uqmars/starter-micromouse/README.md

# UQ MARS Starter Micromouse Design

This repository houses the design and drivers for the starter Micromouse design provided by UQ MARS.

To find out more about the Micromouse competition, see the rules [here](https://github.com/uqmars/micromouse-spec/releases).
