uqmars/starter-micromouse/PCB V2 Design/README.md

# MARS_Micromouse
Micromouse pcb designed for the UQ MARS micromouse workshop series.
