uqmars/starter-micromouse/PCB V2 Design/Bill of Materials.xlsx

Sheet: Robot
Name | Type | Material | Qty | Cost | Subtotal | Link
Micromouse PCB Assembly | Internally Manufactured |  | 1 | -
Top Plate 3D Print | 3D Printed | PLA | 1 | -
Base Plate 3D Print | 3D Printed | PLA | 1 | -
Motor Clamp 3D Print | 3D Printed | PLA | 2 | -
Caster Ball Extension 3D Print | 3D Printed | PLA | 1 | -
IR Proximity Sensor | Purchased |  | 3 | $0.70 | $2.10 | Aliexpress (https://www.aliexpress.com/item/1005006749168692.html)
N20 Motor with Encoder (6V 100RPM) | Purchased |  | 2 | $9.33 | $18.66 | Aliexpress (https://www.aliexpress.com/item/1005007571722097.html)
N20 Motor 43mm Wheel | Purchased |  | 2 | $1.60 | $3.20 | Aliexpress (https://www.aliexpress.com/item/1005007811650639.html)
Caster Ball | Purchased |  | 1 | $0.50 | $0.50 | Aliexpress (https://www.aliexpress.com/item/1005008096943126.html)
M3 x 8mm Hex Button Screw | Purchased | Stainless Steel | 15 | $0.10 | $1.50 | Aliexpress (https://www.aliexpress.com/item/32967225441.html?curPageLogUid=vMDo78oz88UZ)
3.7V 1S 2000mAh LiPo Battery | Purchased |  | 1 | $15.30 | $15.30 | Core Electronics (https://core-electronics.com.au/polymer-lithium-ion-battery-2000mah-38459.html)
USB-C Lipo Charger | Purchased |  | 1 | $7.60 | $7.60 | Core Electronics (https://core-electronics.com.au/makerverse-usb-c-lipo-charger.html)
Raspberry Pi Pico | Purchased |  | 1 | $3.89 | $3.89 | Aliexpress (https://www.aliexpress.com/item/1005007393927221.html)
JST XH 6-Pin Male/Female Pair (straight) | Purchased |  | 2 | $0.33 | $0.66 | Aliexpress (https://www.aliexpress.com/item/1005007080333485.html)
JST PH 2-Pin Male PCB Connector (straight) | Purchased |  | 1 | $0.02 | $0.02 | Aliexpress (https://www.aliexpress.com/item/1005004708000514.html)
 |  |  | Total: |  | $52.75

Sheet: PCB
Index | DigiKey Part # | Manufacturer Part Number | Manufacturer | Description | Customer Reference | Quantity | Backorder | Unit Price | Extended Price
1 | 2223-SLW-1678105-6A-N-D-ND | SLW-1678105-6A-N-D | Same Sky (Formerly CUI Devices) | 16 X 7.8 X 10.5 MM, 6 MM RAISED |  | 18 | 0 | $0.98 | $17.62
2 | 5399-SL2301SCT-ND | SL2301S | Shenzhen Slkormicro Semicon Co., Ltd. | 20V 2.4A 140M@4.5V,2.4A 900MW 1. |  | 35 | 0 | $0.10 | $3.43
3 | 5399-DSK24CT-ND | DSK24 | Shenzhen Slkormicro Semicon Co., Ltd. | 40V 550MV@2A 2A SOD-123FL |  | 35 | 0 | $0.11 | $3.71
4 | 296-DRV8210DRLRCT-ND | DRV8210DRLR | Texas Instruments | 12-V, 1.76-A BRUSHED DC MOTOR DR |  | 35 | 0 | $0.70 | $24.42
5 | 311-10KJRCT-ND | RC0402JR-0710KL | YAGEO | RES 10K OHM 5% 1/16W 0402 |  | 500 | 0 | $0.00448 | $2.24
6 | 311-100KLRCT-ND | RC0402FR-07100KL | YAGEO | RES 100K OHM 1% 1/16W 0402 |  | 250 | 0 | $0.0049 | $1.23
7 | 13-RC0402JR-13220RLCT-ND | RC0402JR-13220RL | YAGEO | RES 220 OHM 5% 1/16W 0402 |  | 100 | 0 | $0.0041 | $0.41
8 | 399-C0603C104K5RACTUCT-ND | C0603C104K5RACTU | KEMET | CAP CER 0.1UF 50V X7R 0603 |  | 100 | 0 | $0.02 | $1.70
 |  |  |  |  |  |  |  | Subtotal | $54.76
 | Please note that the table shown above is the order placed to manufacture 16 robot units. This includes spare parts due to errors during manufacturing. Refer to the table below for exact quantities required for a single PCB
Index | DigiKey Part # | Manufacturer Part Number | PCB Designator | Description | Quantity | Unit Price | Extended Price
1 | 2223-SLW-1678105-6A-N-D-ND | SLW-1678105-6A-N-D | SW2 | 16 X 7.8 X 10.5 MM, 6 MM RAISED | 1 | $0.98 | $0.98
2 | 5399-SL2301SCT-ND | SL2301S | Q1, Q2 | 20V 2.4A 140M@4.5V,2.4A 900MW 1. | 2 | $0.10 | $0.20
3 | 5399-DSK24CT-ND | DSK24 | D3 | 40V 550MV@2A 2A SOD-123FL | 1 | $0.11 | $0.11
4 | 296-DRV8210DRLRCT-ND | DRV8210DRLR | U1, U2 | 12-V, 1.76-A BRUSHED DC MOTOR DR | 2 | $0.70 | $1.40
5 | 311-10KJRCT-ND | RC0402JR-0710KL | R3, R7 | RES 10K OHM 5% 1/16W 0402 | 2 | $0.00448 | $0.01
6 | 311-100KLRCT-ND | RC0402FR-07100KL | R4 | RES 100K OHM 1% 1/16W 0402 | 1 | $0.0049 | $0.0049
7 | 13-RC0402JR-13220RLCT-ND | RC0402JR-13220RL | R1, R2 | RES 220 OHM 5% 1/16W 0402 | 2 | $0.0041 | $0.01
8 | 399-C0603C104K5RACTUCT-ND | C0603C104K5RACTU | C1, C7, C6 | CAP CER 0.1UF 50V X7R 0603 | 3 | $0.02 | $0.05
9 | 160-1179-1-ND | LTST-C170GKT | D2 | LED GREEN CLEAR SMD | 1 | $0.16 | $0.16
10 | 160-1427-1-ND | LTST-C171KRKT | D1 | LED RED CLEAR SMD | 1 | $0.21 | $0.21
 |  |  |  |  |  | Subtotal | $3.12
Generic electrolytic capacitors will need to be purchased for (C2, C3, C4, and C5)
Generic THT 6mm pushbutons should be purchased for (SW1, and SW2)
2.54mm male pin headers should be purchased for most of the breakout pins
2x20mm Female pin headers need to be purchased for mounting the Raspberry Pi on the board.
