uqmars/starter-micromouse/CAD/STL/Motor Clamp.stl

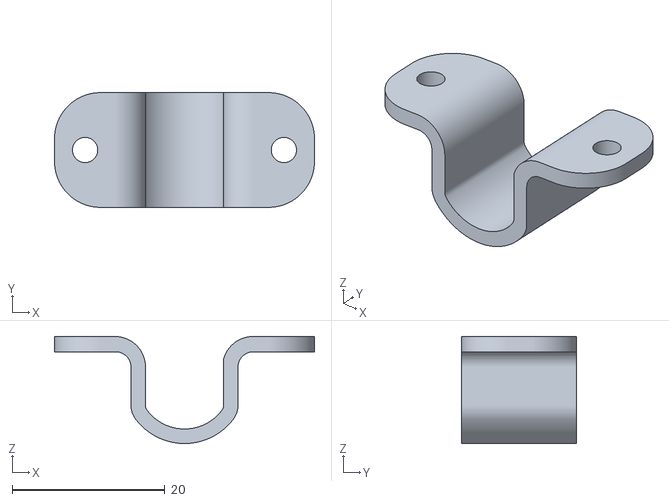
[picture p2: CAD file, 2026-08-11]
CAD/STL/Motor Clamp.stl
34.0 x 15.0 x 14.0
