uqmars/starter-micromouse/PCB V2 Design/MARS_Micromouse_PCB.step

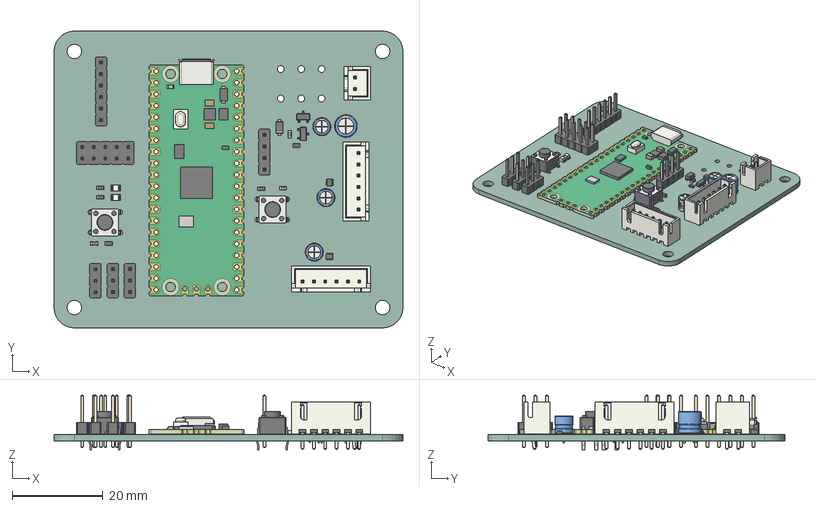
[picture p3: CAD file, 2026-01-06]
PCB V2 Design/MARS_Micromouse_PCB.step
77.0 x 65.5 x 12.0 mm
SOT-23 x 2
PinHeader_1x03_P2.54mm_Vertical x 3
SW_PUSH_6mm_H5mm x 2
JST_XH_B6B-XH-A_1x06_P2.50mm_Vertical x 2
C_0603_1608Metric x 3
R_0603_1608Metric x 5
LED_0805_2012Metric x 2
SOT-563 x 2
PinHeader_1x04_P2.54mm_Vertical
CP_Radial_D5.0mm_P2.50mm
D_SOD-123F
RaspberryPi_Pico_Module_KiCad
JST_XH_B2B-XH-A_1x02_P2.50mm_Vertical
CP_Radial_D4.0mm_P2.00mm x 3
PinHeader_2x05_P2.54mm_Vertical
PinHeader_1x06_P2.54mm_Vertical
MARS_Micromouse_PCB
