uqmars/starter-micromouse/CAD/STL/Top Plate.stl

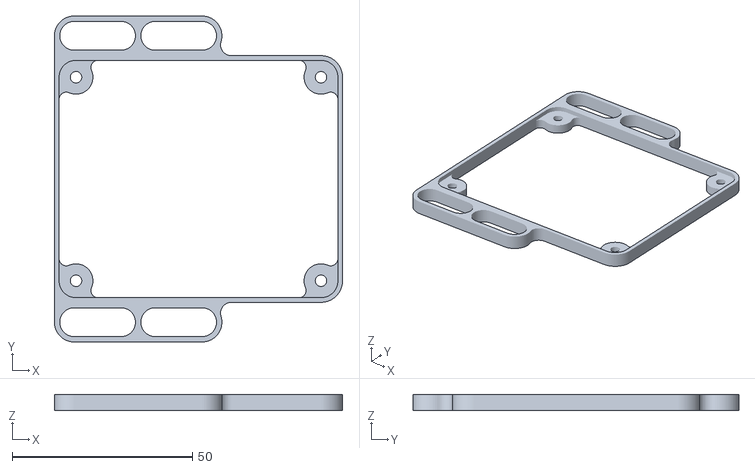
[picture p4: CAD file, 2026-08-11]
CAD/STL/Top Plate.stl
80.0 x 90.5 x 4.51
