uqmars/starter-micromouse/CAD/STL/Caster Ball Extension.stl

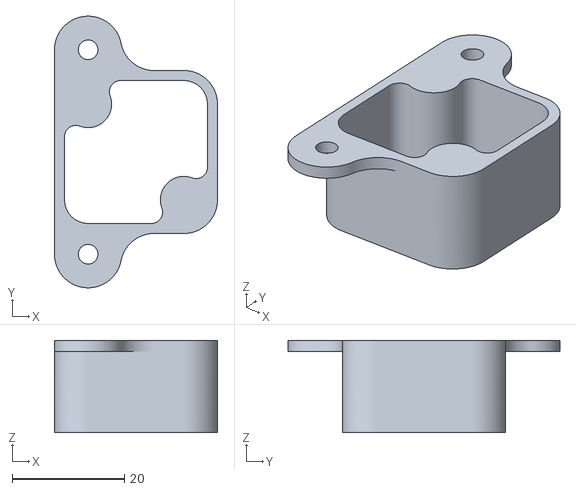
[picture p5: CAD file, 2026-08-11]
CAD/STL/Caster Ball Extension.stl
29.1 x 48.5 x 16.5
