uqmars/starter-micromouse/CAD/STL/Base Plate.stl

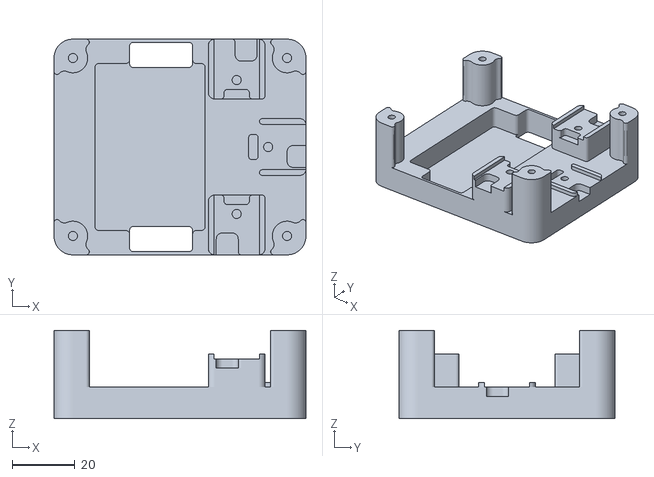
[picture p6: CAD file, 2026-08-11]
CAD/STL/Base Plate.stl
80.0 x 68.5 x 28.0
