uqmars/starter-micromouse/(list of files, cad)

Other CAD files:
CAD/MARS Micromouse.f3z
CAD/MARS Micromouse.ipn
CAD/MARS Micromouse/Base Plate.ipt
CAD/MARS Micromouse/CP_Radial_D4.0mm_P2.00mm.ipt
CAD/MARS Micromouse/CP_Radial_D5.0mm_P2.50mm.ipt
CAD/MARS Micromouse/C_0603_1608Metric.ipt
CAD/MARS Micromouse/Caster Ball Extension.ipt
CAD/MARS Micromouse/Caster Ball v3.ipt
CAD/MARS Micromouse/D_SOD-123F.ipt
CAD/MARS Micromouse/Housing.ipt
CAD/MARS Micromouse/Hub.ipt
CAD/MARS Micromouse/IR_Sensor_YL63 v1.ipt
CAD/MARS Micromouse/JST_XH_B2B-XH-A_1x02_P2.50mm_Vertical.ipt
CAD/MARS Micromouse/JST_XH_B6B-XH-A_1x06_P2.50mm_Vertical.ipt
CAD/MARS Micromouse/LED_0805_2012Metric.ipt
CAD/MARS Micromouse/MARS Micromouse.iam
CAD/MARS Micromouse/MARS_Micromouse_PCB v1.iam
CAD/MARS Micromouse/MARS_Micromouse_PCB.ipt
CAD/MARS Micromouse/Motor Clamp.ipt
CAD/MARS Micromouse/N20 Mini Micro Metall Gear Motor v1.ipt
CAD/MARS Micromouse/New Battery.ipt
CAD/MARS Micromouse/OldVersions/RC wheel v1.0002.iam
CAD/MARS Micromouse/PinHeader_1x03_P2.54mm_Vertical.ipt
CAD/MARS Micromouse/PinHeader_1x04_P2.54mm_Vertical.ipt
CAD/MARS Micromouse/PinHeader_1x06_P2.54mm_Vertical.ipt
CAD/MARS Micromouse/PinHeader_2x05_P2.54mm_Vertical.ipt
CAD/MARS Micromouse/RC wheel v1.iam
CAD/MARS Micromouse/R_0603_1608Metric.ipt
CAD/MARS Micromouse/RaspberryPi_Pico.iam
CAD/MARS Micromouse/RaspberryPi_Pico_Module_KiCad.ipt
CAD/MARS Micromouse/SOT-23.ipt
CAD/MARS Micromouse/SOT-563.ipt
CAD/MARS Micromouse/SW_PUSH_6mm_H5mm.ipt
CAD/MARS Micromouse/Top Plate.ipt
CAD/OldVersions/MARS Micromouse.0001.ipn
