uqmars/starter-micromouse/CAD/Micromouse Starter Robot Assembly Instructions.docx

Micromouse Starter Robot Assembly Instructions

Author | Binara Wasala
Last Revision | 12/07/2026
Revision | A

Parts:

Part | Qty.
3.7V LiPo Battery | 1
43mm Rubber Wheel | 2
Caster Ball | 1
IR Sensor | 3
M3x8mm Hex Socket Bolt | 15
Micro Motor 60RPM | 2
MM Base Plate | 1
MM Caster Ball Extension | 1
MM Motor Clamp | 2
MM PCB | 1
MM Top Plate | 1

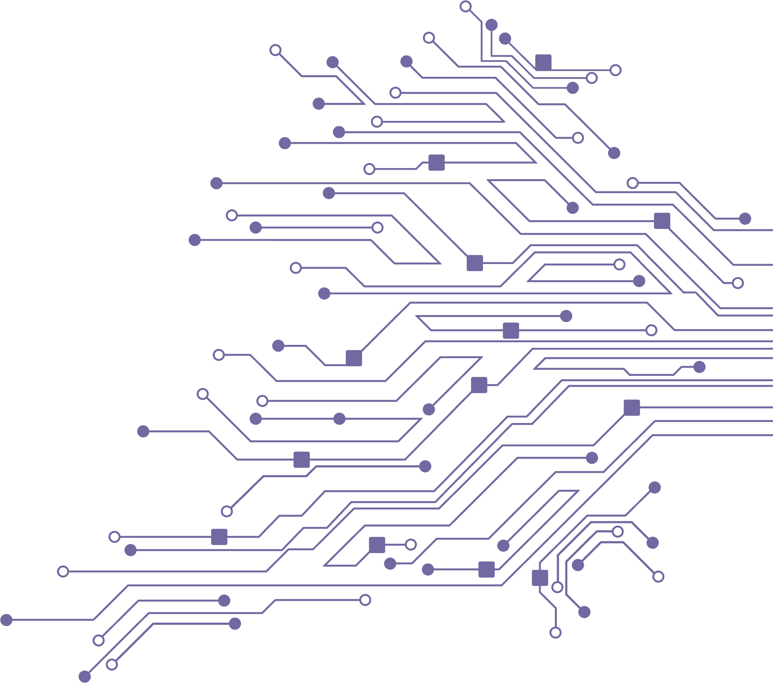
[picture p7: figure]

| Micromouse Starter Robot | Step: | 1

Parts Required:

A. 1 x MM Base Plate
B. 1 x MM Caster Ball Extension
C. 2 x M3x8mm Hex Socket Bolt

Instructions:

1. Fasten the MM Caster Ball Extension (B) to the MM Base Plate (A) using M3x8mm bolts (C).

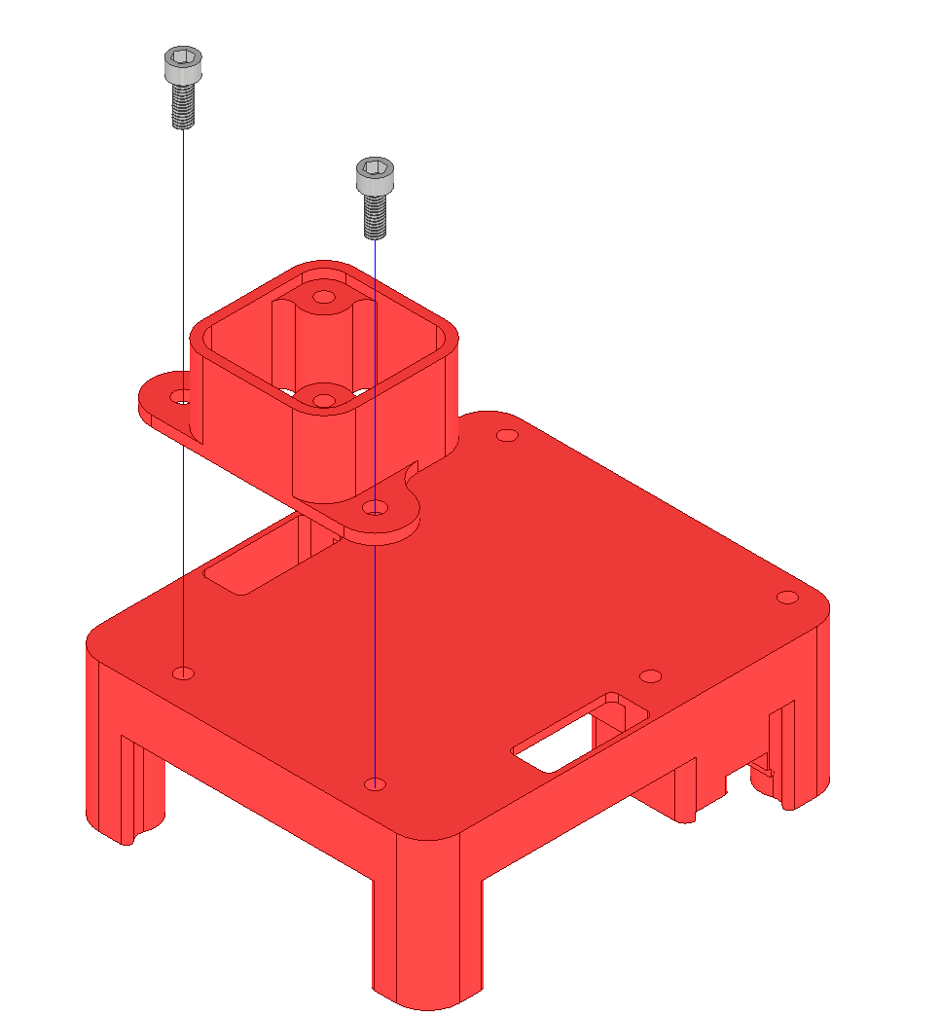
[picture p8: figure]

2 x C

B

A
| Micromouse Starter Robot | Step: | 2

Parts Required:

A. 1 x MM Base Plate with components fitted (where step 1 of this procedure has been completed)
B. 1 x Caster Ball
C. 2 x M3x8mm Hex Socket Bolt

Instructions:

1. Fasten the Caster Ball (B) to the MM Base Plate (A) using M3x8mm bolts (C).

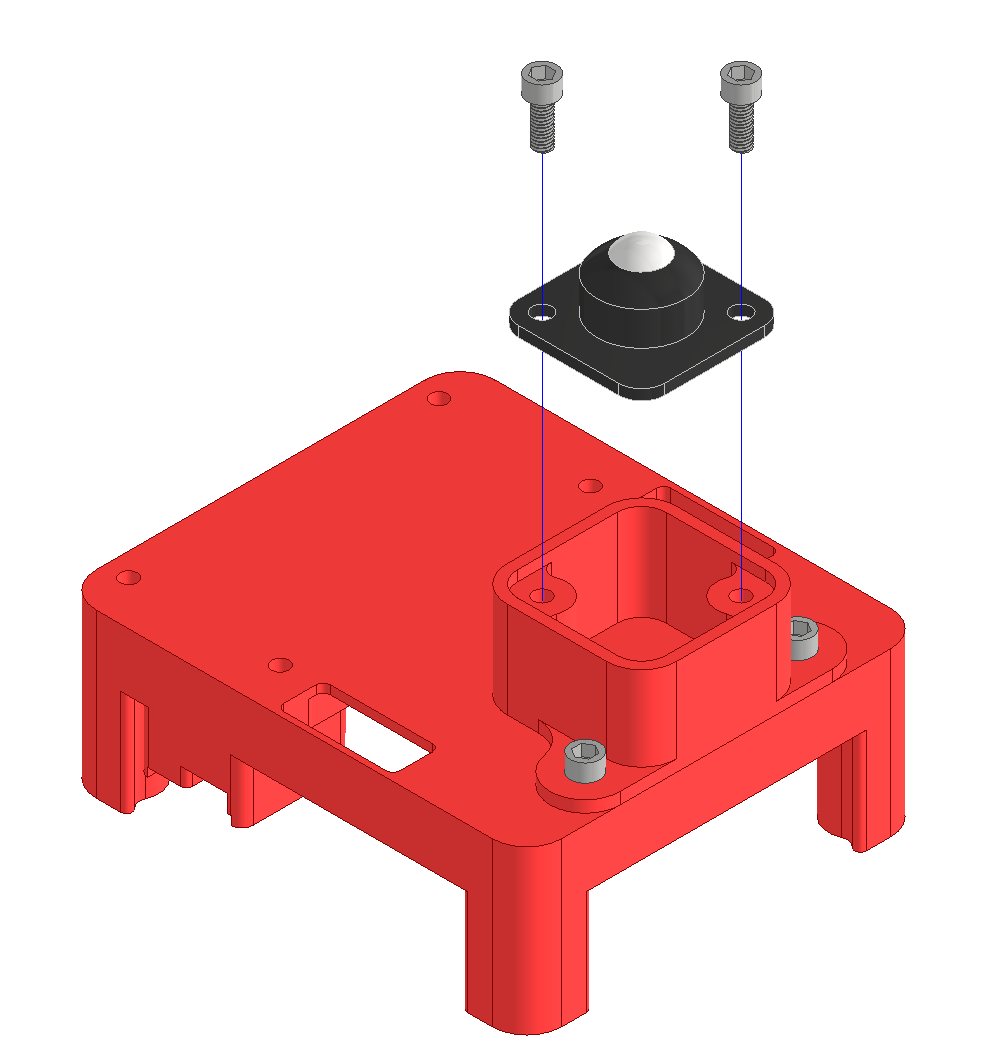
[picture p9: figure]

2 x C

A

B
| Micromouse Starter Robot | Step: | 3

Parts Required:

A. 1 x MM Base Plate with components fitted (where steps 1 to 2 of this procedure have been completed)
B. 2 x MM Motor Clamp
C. 2 x Micro Motor 60RPM
D. 4 x M3x8mm Hex Socket Bolt

Instructions:

1. Place the Micro Motors (C) on the MM Base Plate (A) and secure using MM Motor Clamps (B).
2. Fasten the MM Motor Clamps (B) to the MM Base Plate (A) using M3x8mm bolts (D).
3. Route the cables from the Micro Motors (C) through the designated holes in the MM Base Plate (A).

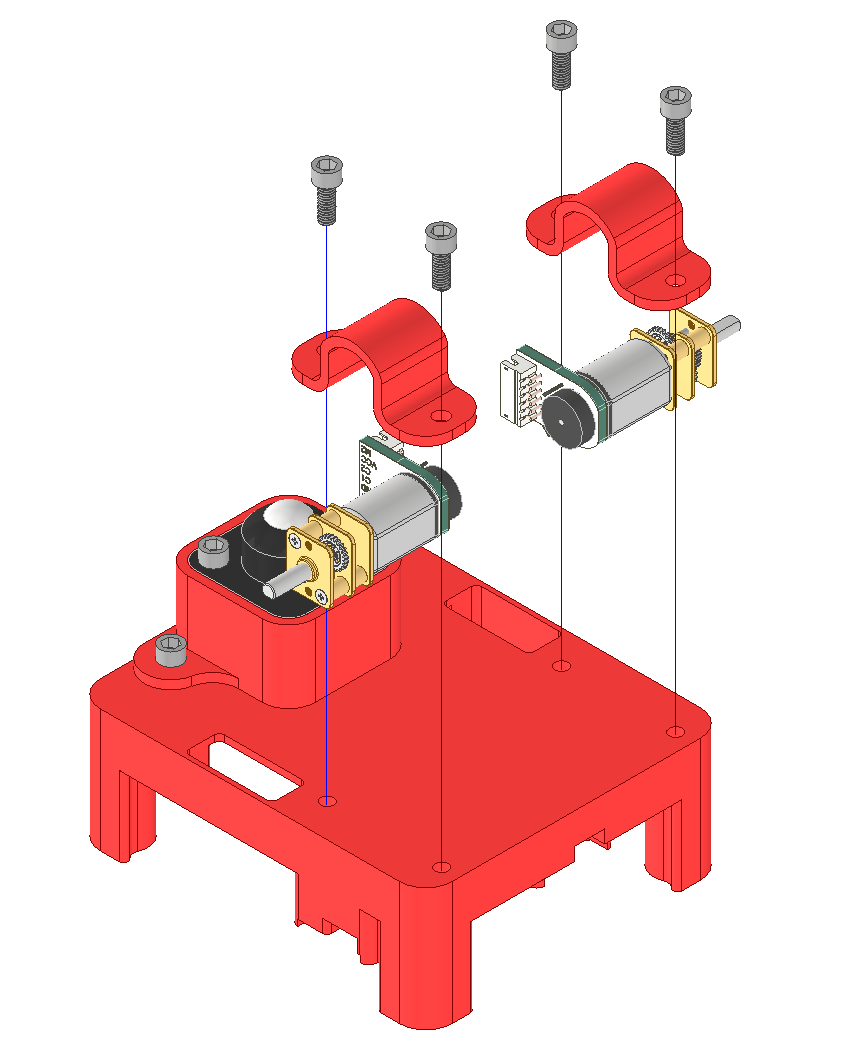
[picture p10: figure]

2 x B

4 x D

2 x C

A
| Micromouse Starter Robot | Step: | 4

Parts Required:

A. 1 x MM Base Plate with components fitted (where steps 1 to 3 of this procedure have been completed)
B. 3 x IR Sensor
C. 3 x M3x8mm Hex Socket Bolt

Instructions:

1. Fasten the IR Sensors (B) to the MM Base Plate (A) using M3x8mm bolts (C).

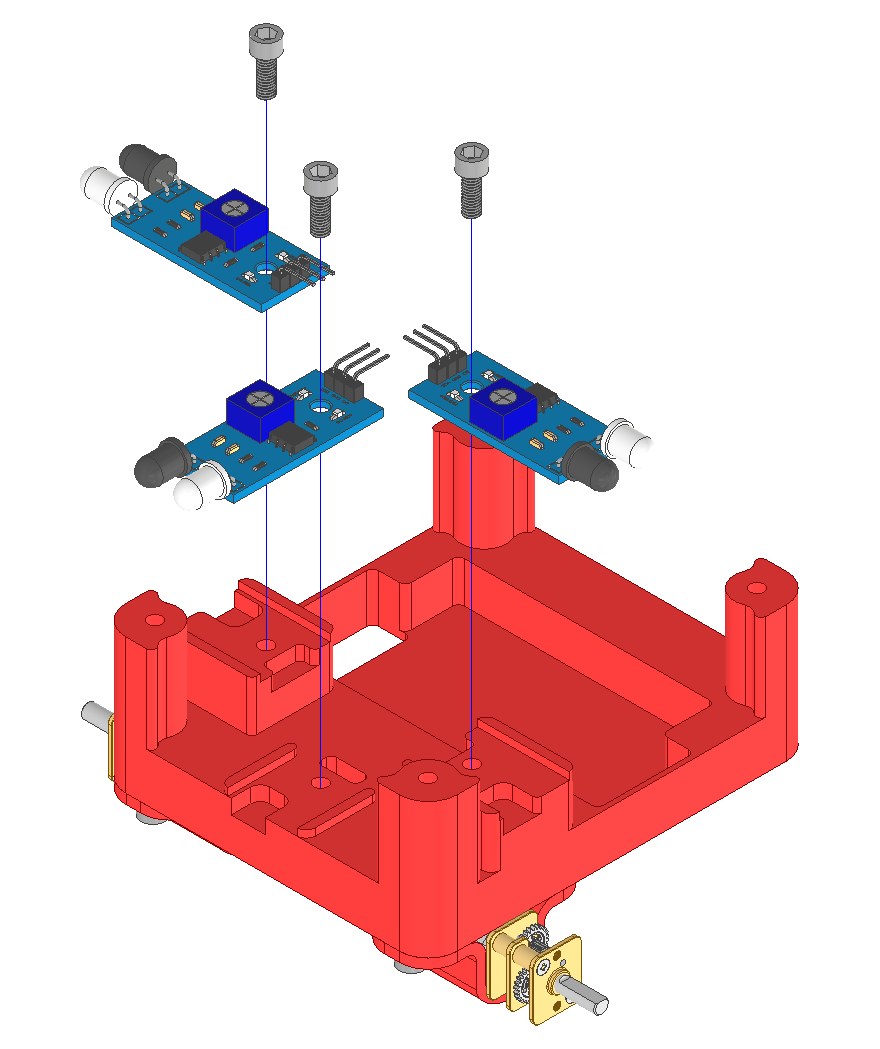
[picture p11: figure]

3 x B

3 x C

A
| Micromouse Starter Robot | Step: | 5

Parts Required:

A. 1 x MM Base Plate with components fitted (where steps 1 to 4 of this procedure have been completed)
B. 1 x 3.7B LiPo Battery

Instructions:

1. Place the LiPo Battery (B) in the designated cutout in the MM Base Plate (A).

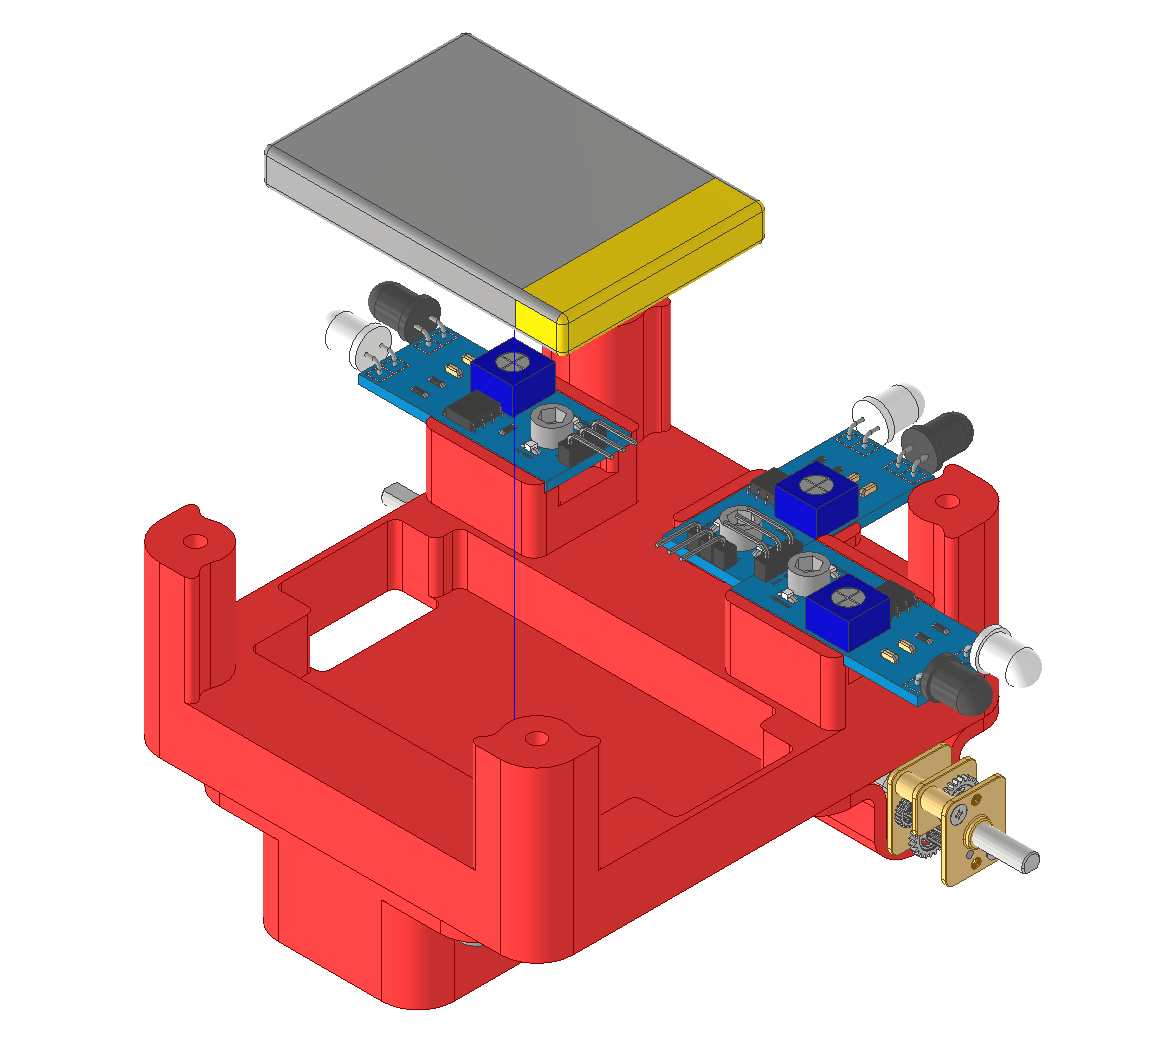
[picture p12: figure]

B

A
| Micromouse Starter Robot | Step: | 6

Parts Required:

A. 1 x MM Base Plate with components fitted (where steps 1 to 5 of this procedure have been completed)
B. 1 x MM Top Plate
C. 1 x MM PCB
D. 4 x M3x8mm Hex Socket Bolt

Instructions:

1. Place the MM Top Plate (B) on the MM Base Plate (A).
2. Rotate the MM PCB (C) to the desired orientation, place on the MM Top Plate (B) and fasten using M3x8mm bolts (D).
3. Route the motor cables, battery cable, and IR sensor cables through the designated holes in the MM Top Plate (B) and connect accordingly to the MM PCB (C).

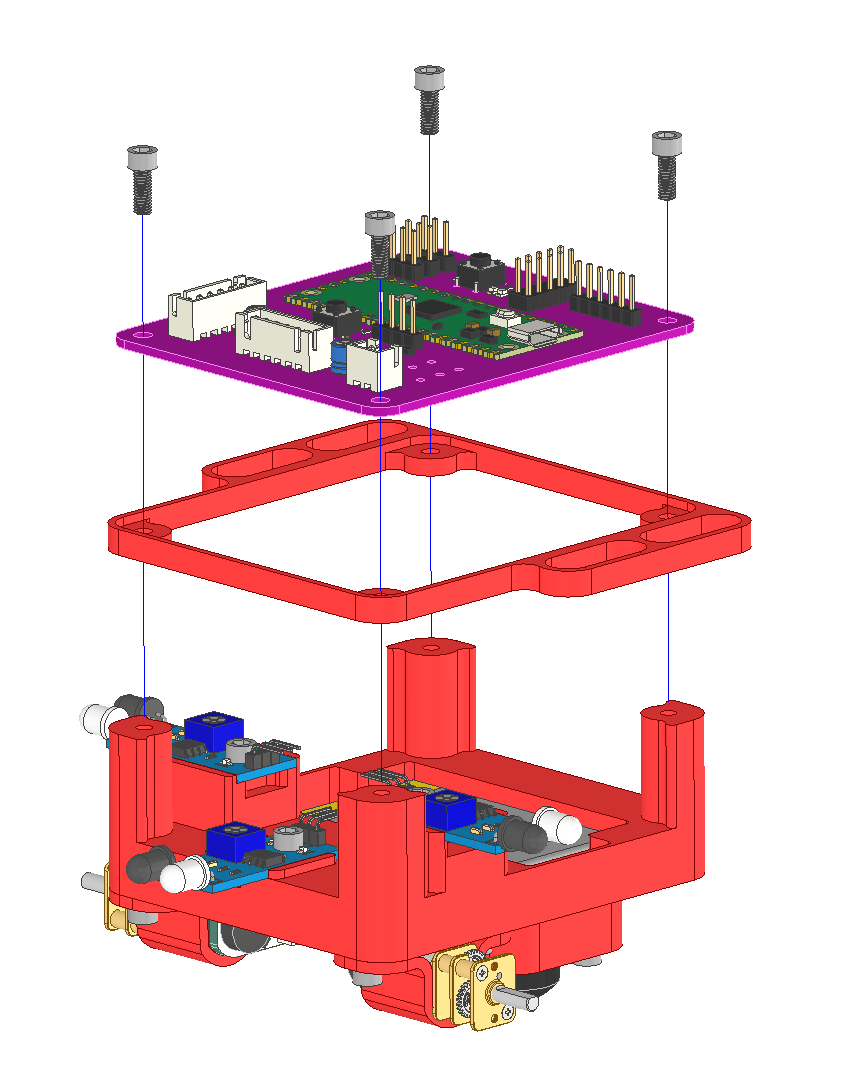
[picture p13: figure]

A

4 x D

B

C
| Micromouse Starter Robot | Step: | 7

Parts Required:

A. 1 x MM Base Plate with components fitted (where steps 1 to 6 of this procedure have been completed)
B. 2 x 43mm Rubber Wheel

Instructions:

1. Connect the 43mm Rubber Wheels (B) onto the motor shafts on the MM Base Plate (A) until flush.

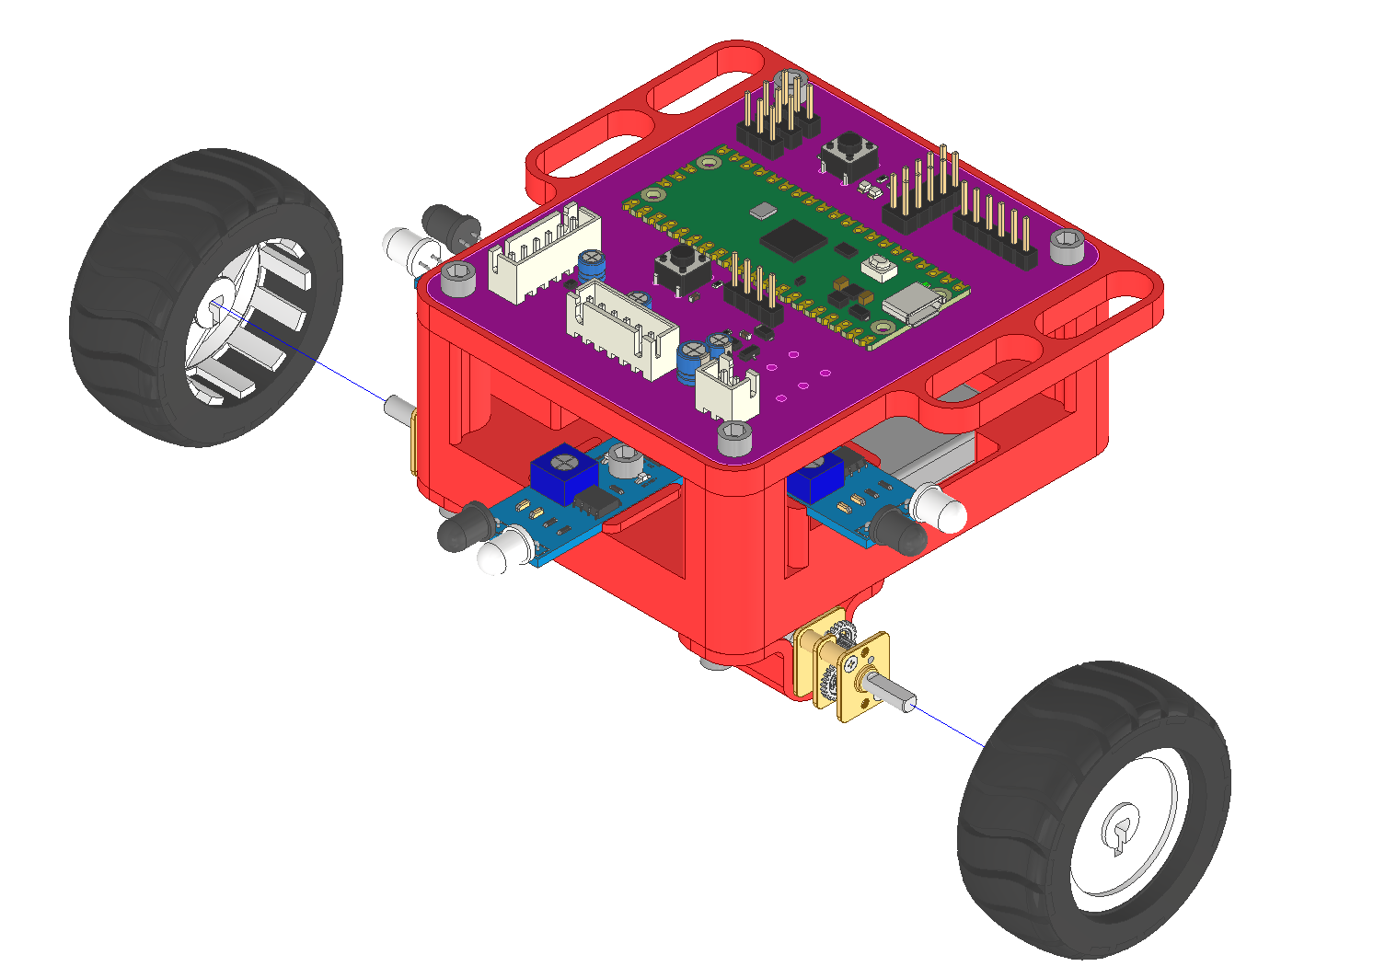
[picture p14: figure]

A

2 x B
| Micromouse Starter Robot | Step: | 8

Parts Required:

Instructions:

1. Assembly Complete.

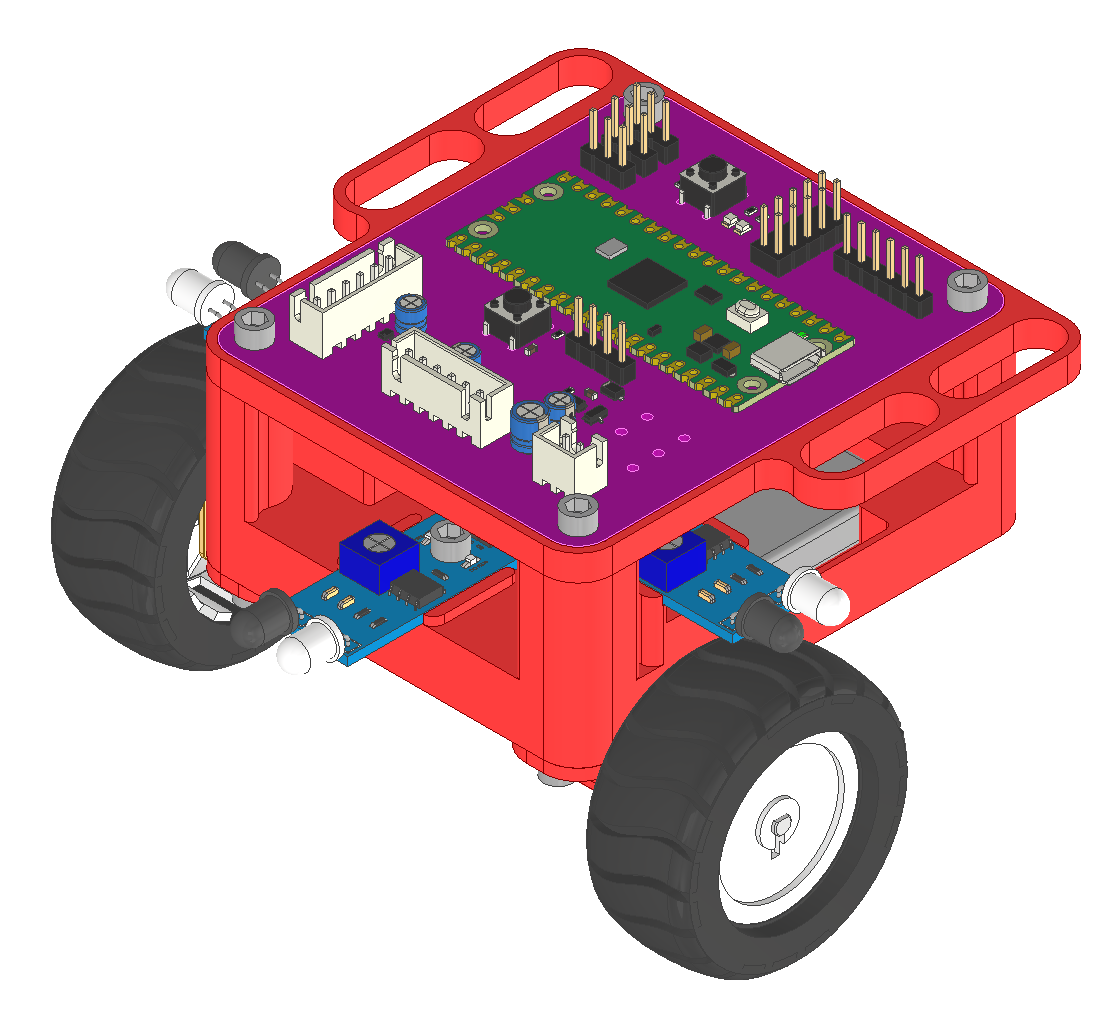
[picture p15: figure]
