uqmars/starter-micromouse/PCB V2 Design/BCopper.pdf

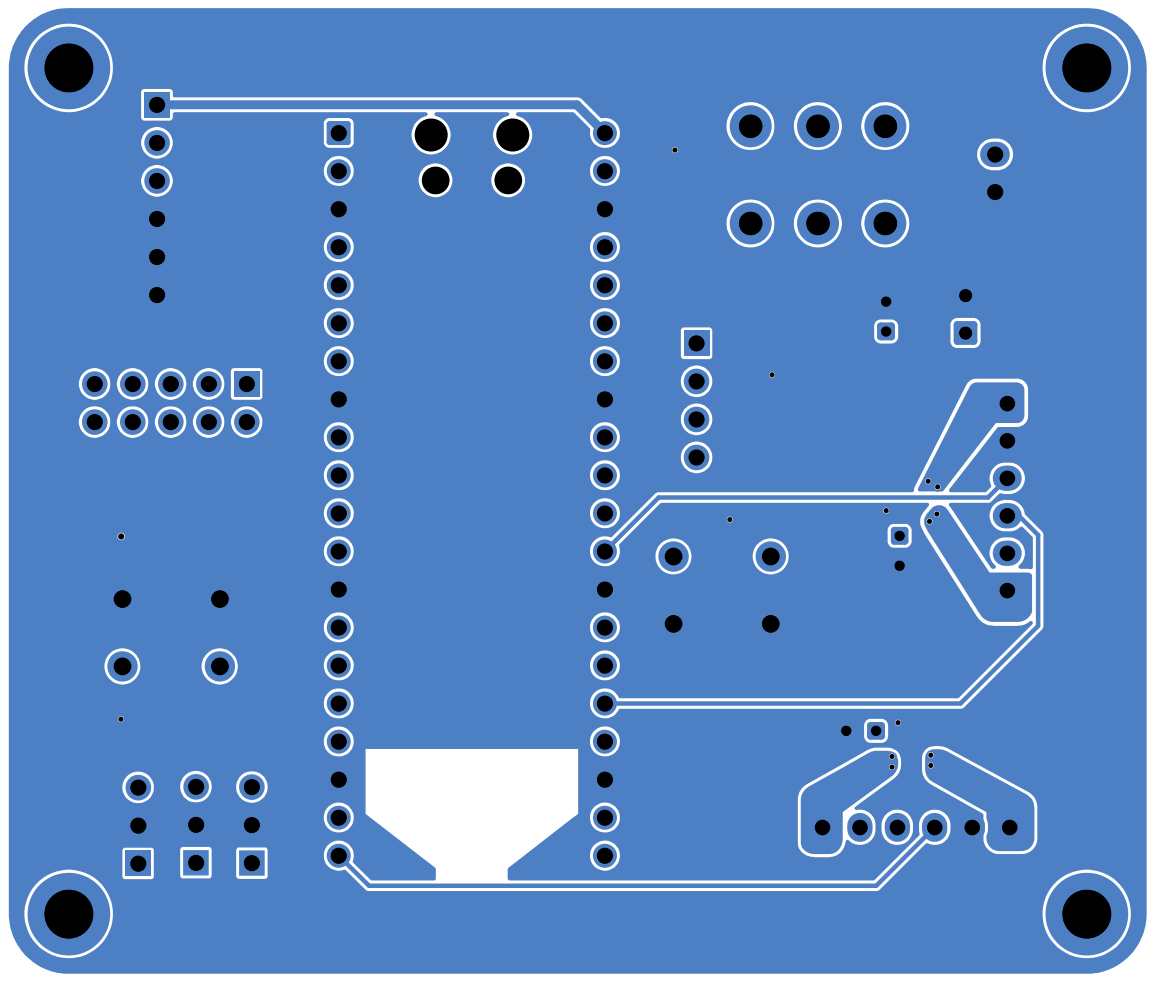
[picture p16: page 1]
