uqmars/starter-micromouse/PCB V2 Design/FCopper.pdf

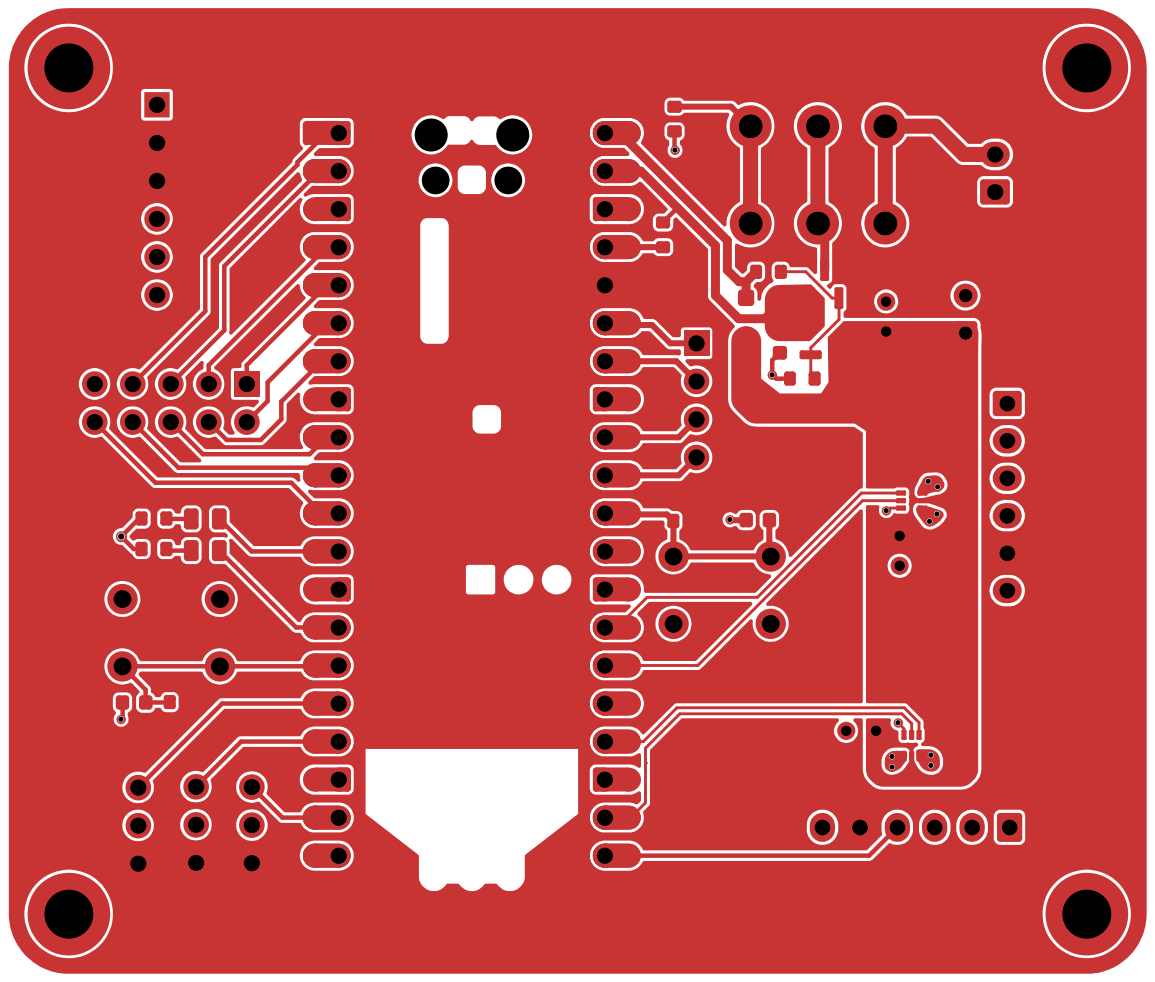
[picture p17: page 1]
