uqmars/starter-micromouse/PCB V2 Design/Schematic.pdf

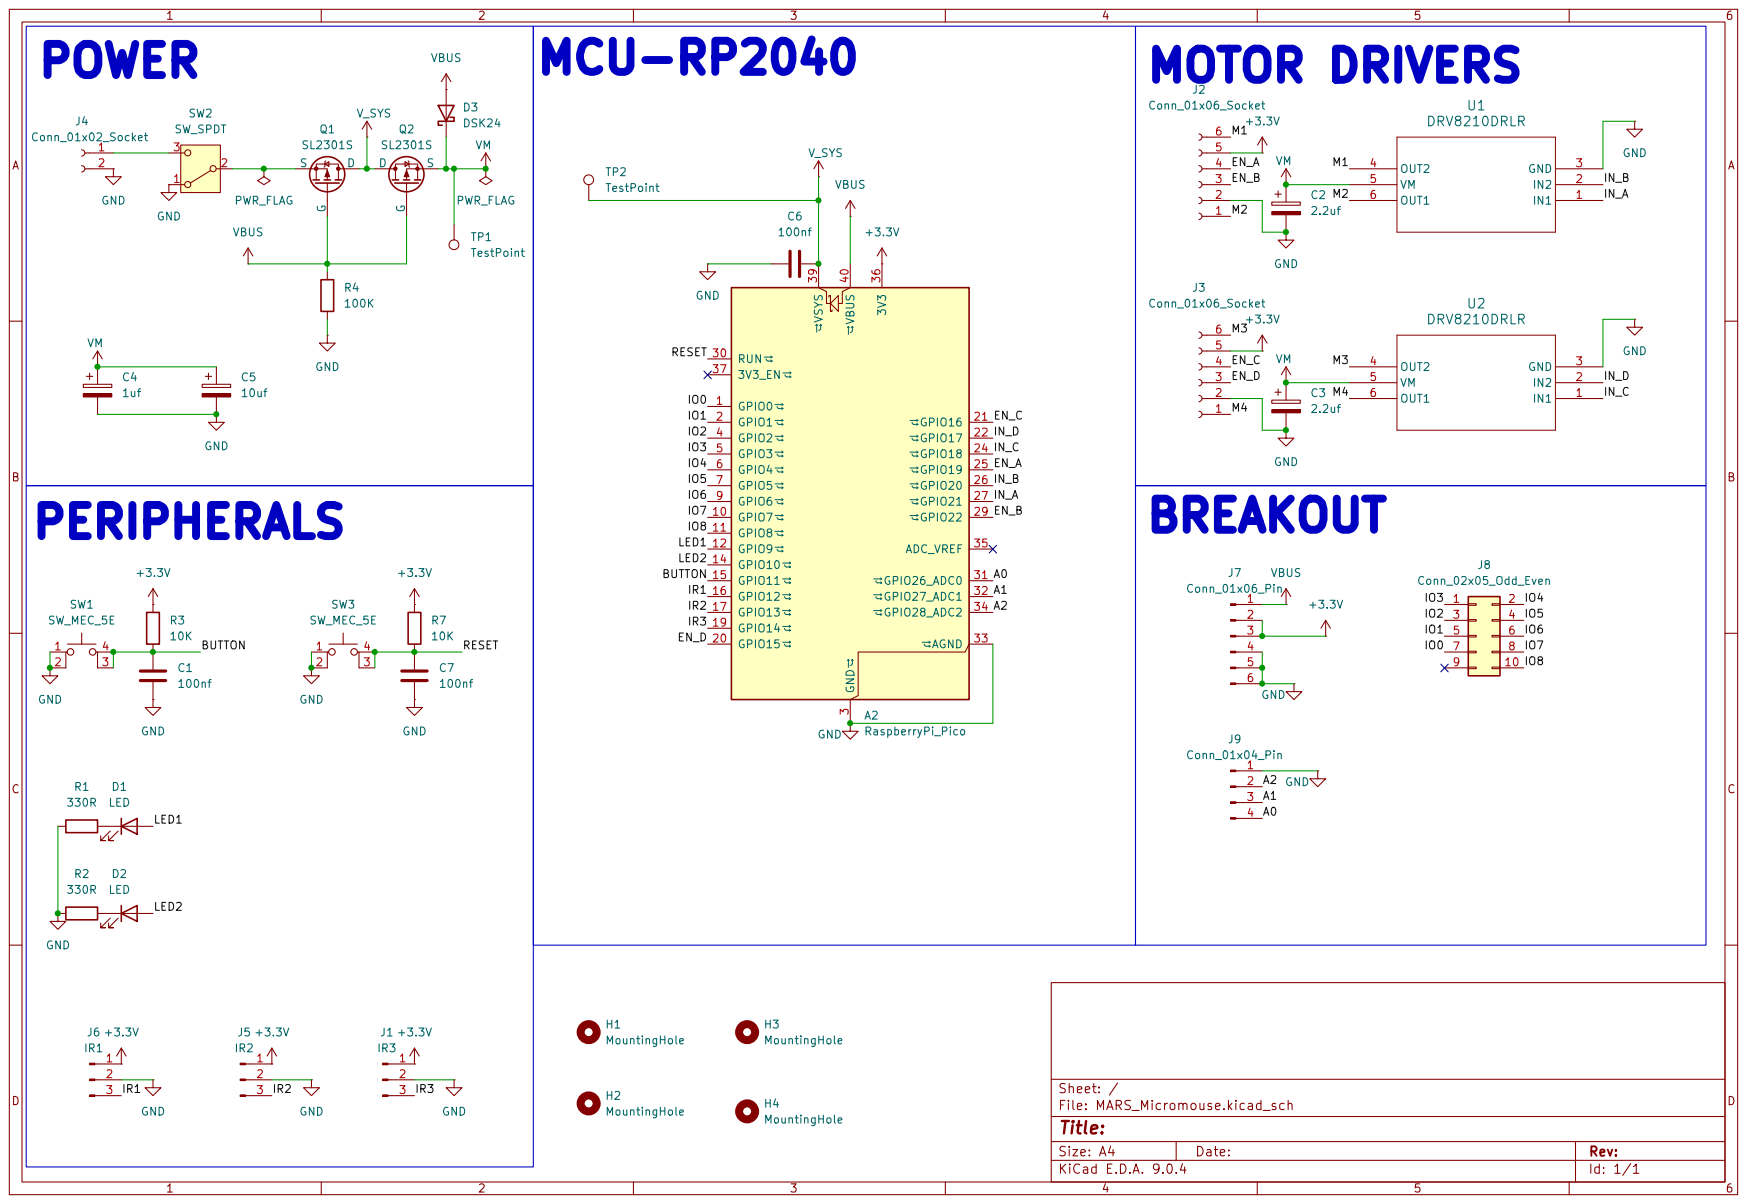
[picture p18: page 1]
