uqmars/starter-micromouse/PCB V2 Design/MARS_Micromouse.kicad_pcb

## KiCad design PCB V2 Design/MARS_Micromouse.kicad_pcb (2026-08-11)

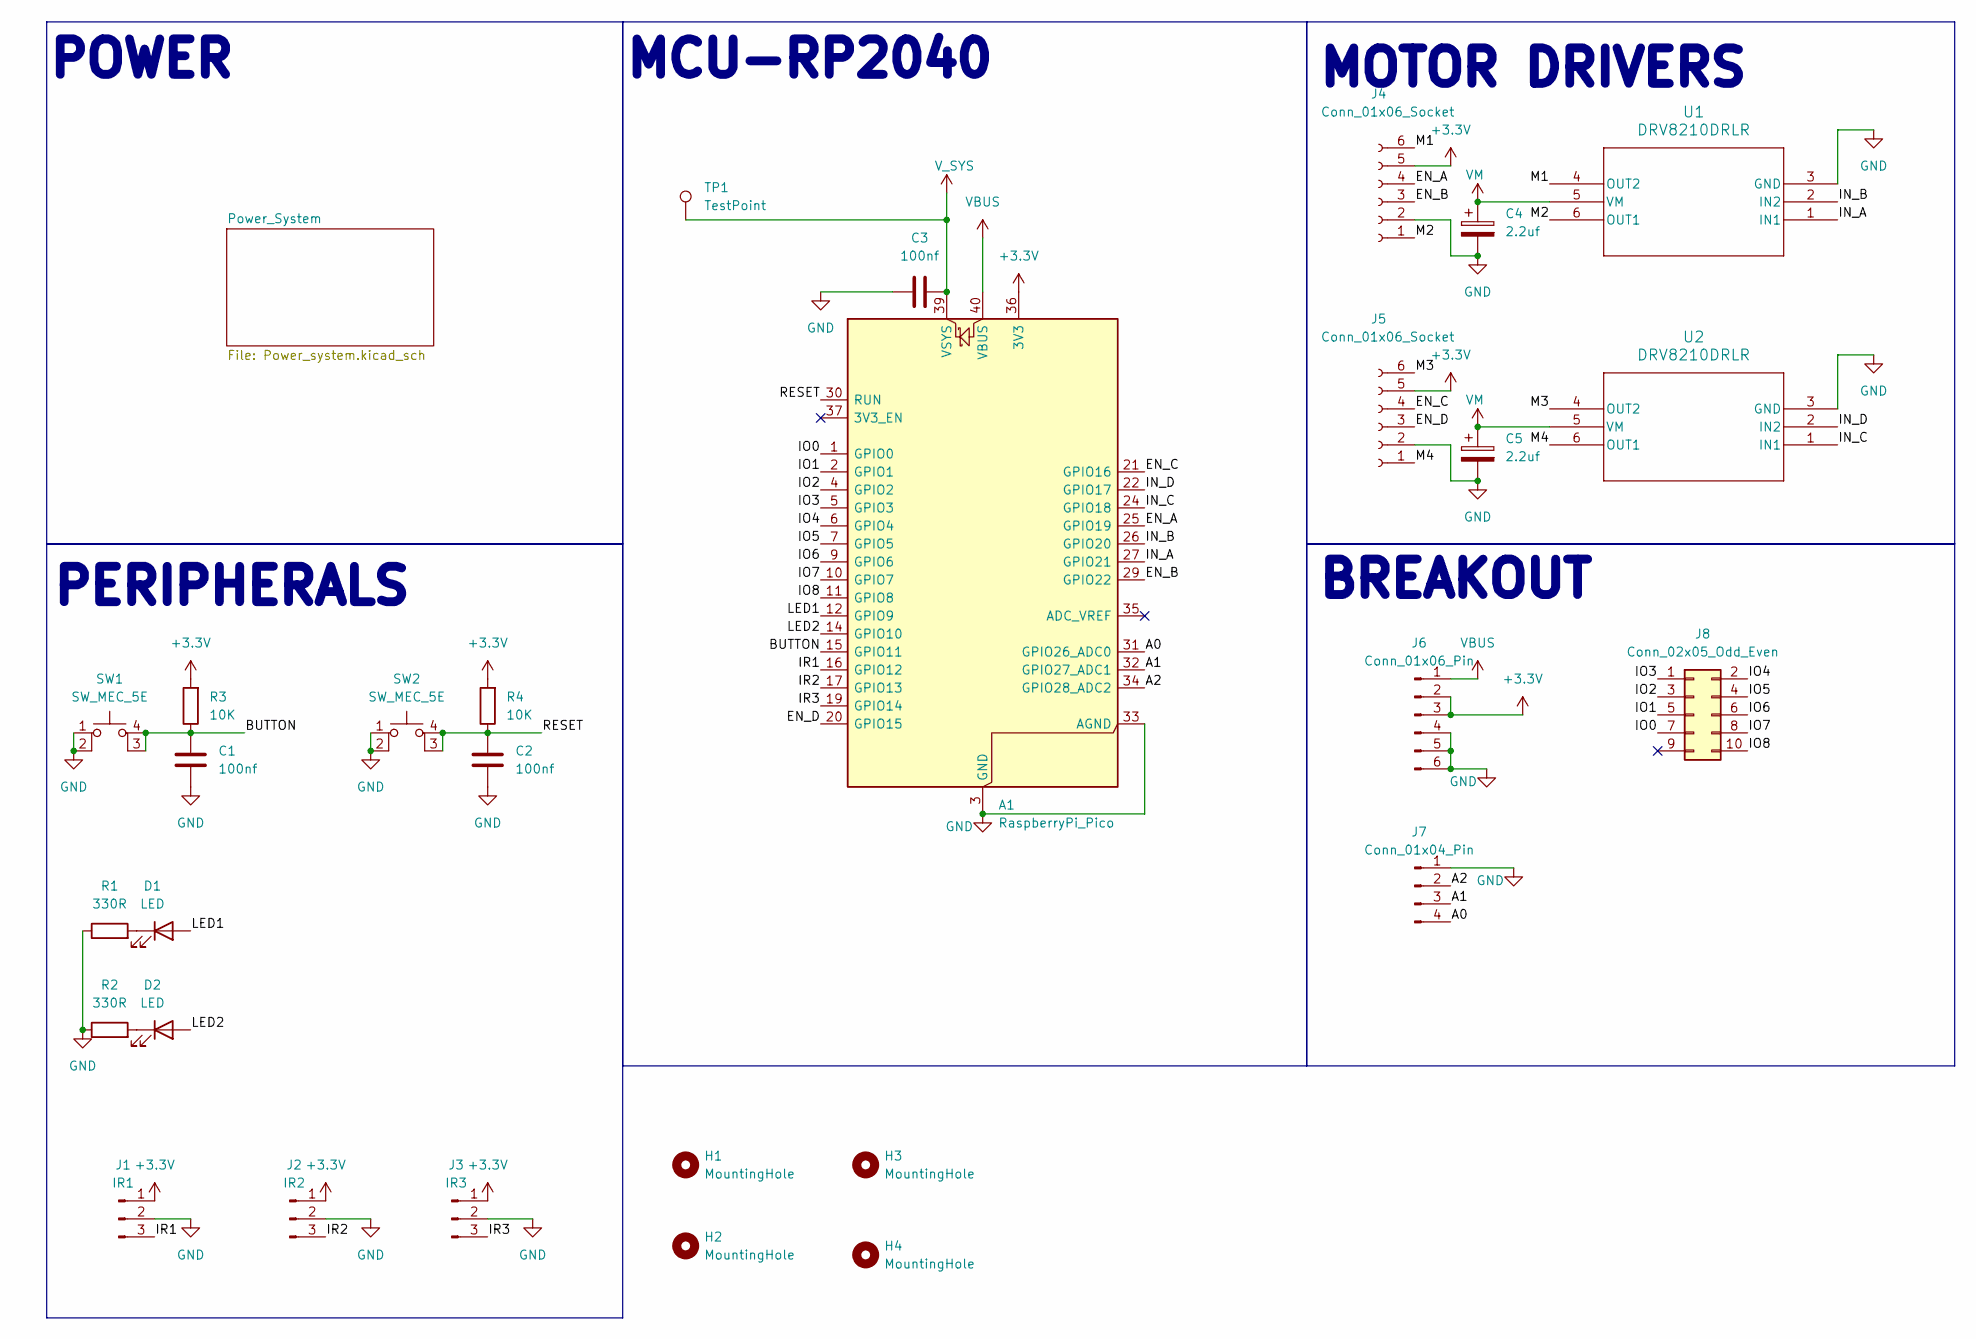
[picture p19: schematic MARS_Micromouse.kicad_sch]

Parts:
A1: RaspberryPi_Pico; RaspberryPi_Pico_Common_Unspecified
C1, C2, C3: 100nf; C_0603_1608Metric
C4, C5: 2.2uf; CP_Radial_D4.0mm_P2.00mm
D1, D2: LED; LED_0805_2012Metric
H1, H2, H3, H4: MountingHole; MountingHole_3.2mm_M3_ISO14580_Pad
J1: IR1; PinHeader_1x03_P2.54mm_Vertical
J2: IR2; PinHeader_1x03_P2.54mm_Vertical
J3: IR3; PinHeader_1x03_P2.54mm_Vertical
J4, J5: Conn_01x06_Socket; JST_XH_B6B-XH-A_1x06_P2.50mm_Vertical
J6: Conn_01x06_Pin; PinHeader_1x06_P2.54mm_Vertical
J7: Conn_01x04_Pin; PinHeader_1x04_P2.54mm_Vertical
J8: Conn_02x05_Odd_Even; PinHeader_2x05_P2.54mm_Vertical
R1, R2: 330R; R_0603_1608Metric
R3, R4: 10K; R_0603_1608Metric
SW1, SW2: SW_MEC_5E; SW_PUSH_6mm_H5mm
TP1: TestPoint; TestPoint_Pad_D1.0mm
U1, U2: DRV8210DRLR; SOT-563

Connections:
+3.3V: A1.36 (3V3), J1.1, J2.1, J3.1, J4.5, J5.5, J6.2, J6.3, R3.2, R4.2
/A0: A1.31 (GPIO26_ADC0), J7.4
/A1: A1.32 (GPIO27_ADC1), J7.3
/A2: A1.34 (GPIO28_ADC2), J7.2
/BUTTON: A1.15 (GPIO11), C1.1, R3.1, SW1.3 (K), SW1.4 (A)
/EN_A: A1.25 (GPIO19), J4.4
/EN_B: A1.29 (GPIO22), J4.3
/EN_C: A1.21 (GPIO16), J5.4
/EN_D: A1.20 (GPIO15), J5.3
/IN_A: A1.27 (GPIO21), U1.1 (IN1)
/IN_B: A1.26 (GPIO20), U1.2 (IN2)
/IN_C: A1.24 (GPIO18), U2.1 (IN1)
/IN_D: A1.22 (GPIO17), U2.2 (IN2)
/IO0: A1.1 (GPIO0), J8.7
/IO1: A1.2 (GPIO1), J8.5
/IO2: A1.4 (GPIO2), J8.3
/IO3: A1.5 (GPIO3), J8.1
/IO4: A1.6 (GPIO4), J8.2
/IO5: A1.7 (GPIO5), J8.4
/IO6: A1.9 (GPIO6), J8.6
/IO7: A1.10 (GPIO7), J8.8
/IO8: A1.11 (GPIO8), J8.10
/IR1: A1.16 (GPIO12), J1.3
/IR2: A1.17 (GPIO13), J2.3
/IR3: A1.19 (GPIO14), J3.3
/LED1: A1.12 (GPIO9), D1.2 (A)
/LED2: A1.14 (GPIO10), D2.2 (A)
/M1: J4.6, U1.4 (OUT2)
/M2: J4.1, U1.6 (OUT1)
/M3: J5.6, U2.4 (OUT2)
/M4: J5.1, U2.6 (OUT1)
/RESET: A1.30 (RUN), C2.1, R4.1, SW2.3 (K), SW2.4 (A)
GND: A1.3 (GND), A1.8 (GND), A1.13 (GND), A1.18 (GND), A1.23 (GND), A1.28 (GND), A1.33 (AGND), A1.38 (GND), C1.2, C2.2, C3.1, C4.2, C5.2, J1.2, J2.2, J3.2, J4.2, J5.2, J6.4, J6.5, J6.6, J7.1, R1.1, R2.1, SW1.1, SW1.2, SW2.1, SW2.2, U1.3 (GND), U2.3 (GND); also elsewhere on the board
unnamed: D1.1 (K), R1.2
unnamed: D2.1 (K), R2.2
VBUS: A1.40 (VBUS), J6.1; also elsewhere on the board
VM: C4.1, C5.1, U1.5 (VM), U2.5 (VM); also elsewhere on the board
V_SYS: A1.39 (VSYS), C3.2, TP1.1 (1_1); also elsewhere on the board

Notes on the sheet:
POWER
MCU-RP2040
BREAKOUT
MOTOR DRIVERS
PERIPHERALS

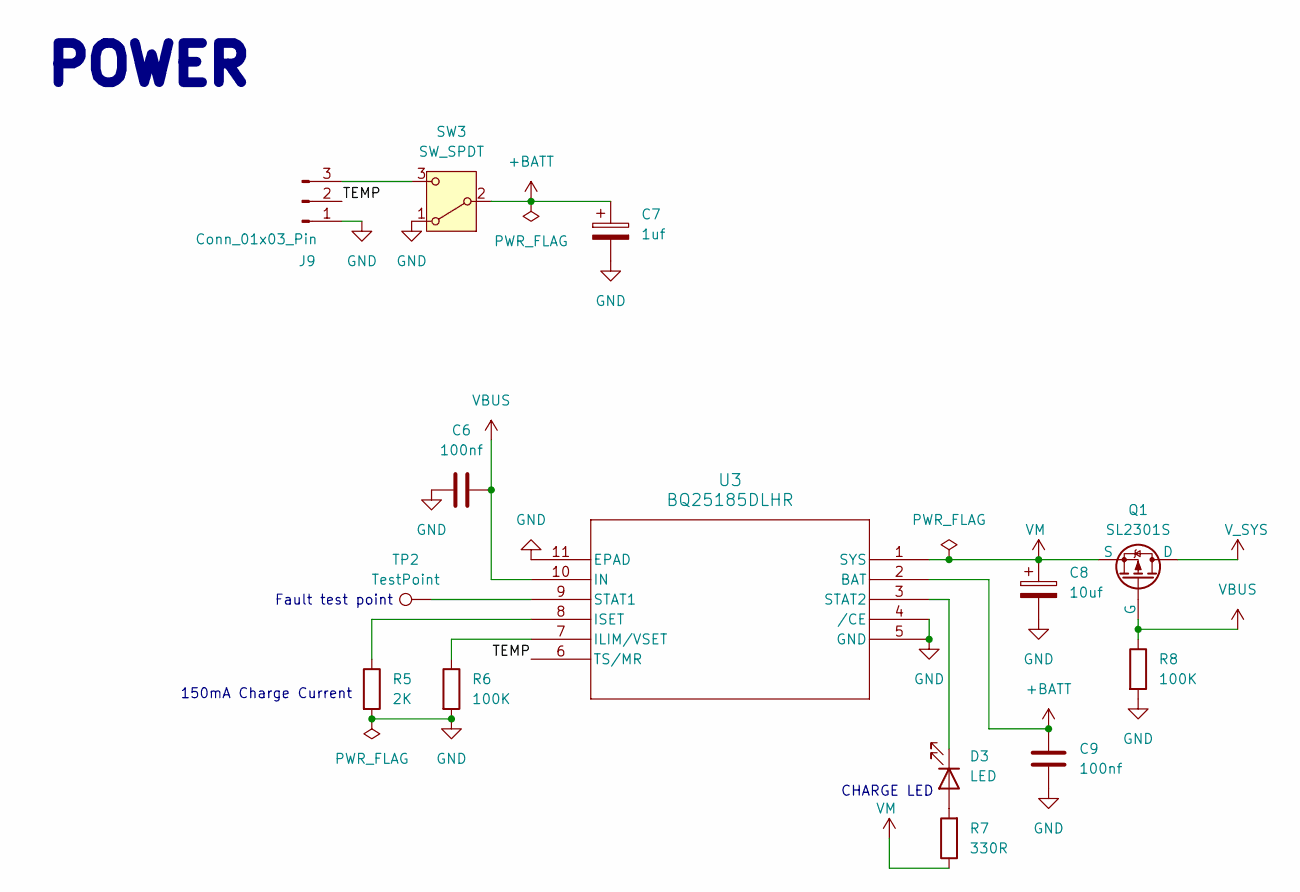
[picture p20: schematic Power_system.kicad_sch]

Parts:
C6, C9: 100nf; C_0603_1608Metric
C7: 1uf; CP_Radial_D4.0mm_P2.00mm
C8: 10uf; CP_Radial_D5.0mm_P2.50mm
D3: LED; LED_0805_2012Metric
J9: Conn_01x03_Pin; JST_PH_B3B-PH-K_1x03_P2.00mm_Vertical
Q1: SL2301S; SOT-23
R5: 2K; R_0603_1608Metric
R6, R8: 100K; R_0603_1608Metric
R7: 330R; R_0603_1608Metric
SW3: SW_SPDT; SLW-1678105-6A-N-D
TP2: TestPoint; TestPoint_Pad_D1.0mm
U3: BQ25185DLHR; WSON10_DLH_TEX

Connections:
+BATT: C7.1, C9.2, SW3.2 (B), U3.2 (BAT)
/Power_System/TEMP: J9.2, U3.6 (TS/MR)
GND: C6.2, C7.2, C8.2, C9.1, J9.1, R5.2, R6.2, R8.2, SW3.1 (A), U3.4 (/CE), U3.5 (GND), U3.11 (EPAD); also elsewhere on the board
unnamed: D3.2 (A), R7.2
unnamed: D3.1 (K), U3.3 (STAT2)
unnamed: J9.3, SW3.3 (C)
unnamed: R6.1, U3.7 (ILIM/VSET)
unnamed: R5.1, U3.8 (ISET)
unnamed: TP2.1 (1_1), U3.9 (STAT1)
VBUS: C6.1, Q1.2 (G), R8.1, U3.10 (IN); also elsewhere on the board
VM: C8.1, Q1.3 (S), R7.1, U3.1 (SYS); also elsewhere on the board
V_SYS: Q1.1 (D); also elsewhere on the board

Notes on the sheet:
Fault test point
POWER
CHARGE LED
150mA Charge Current

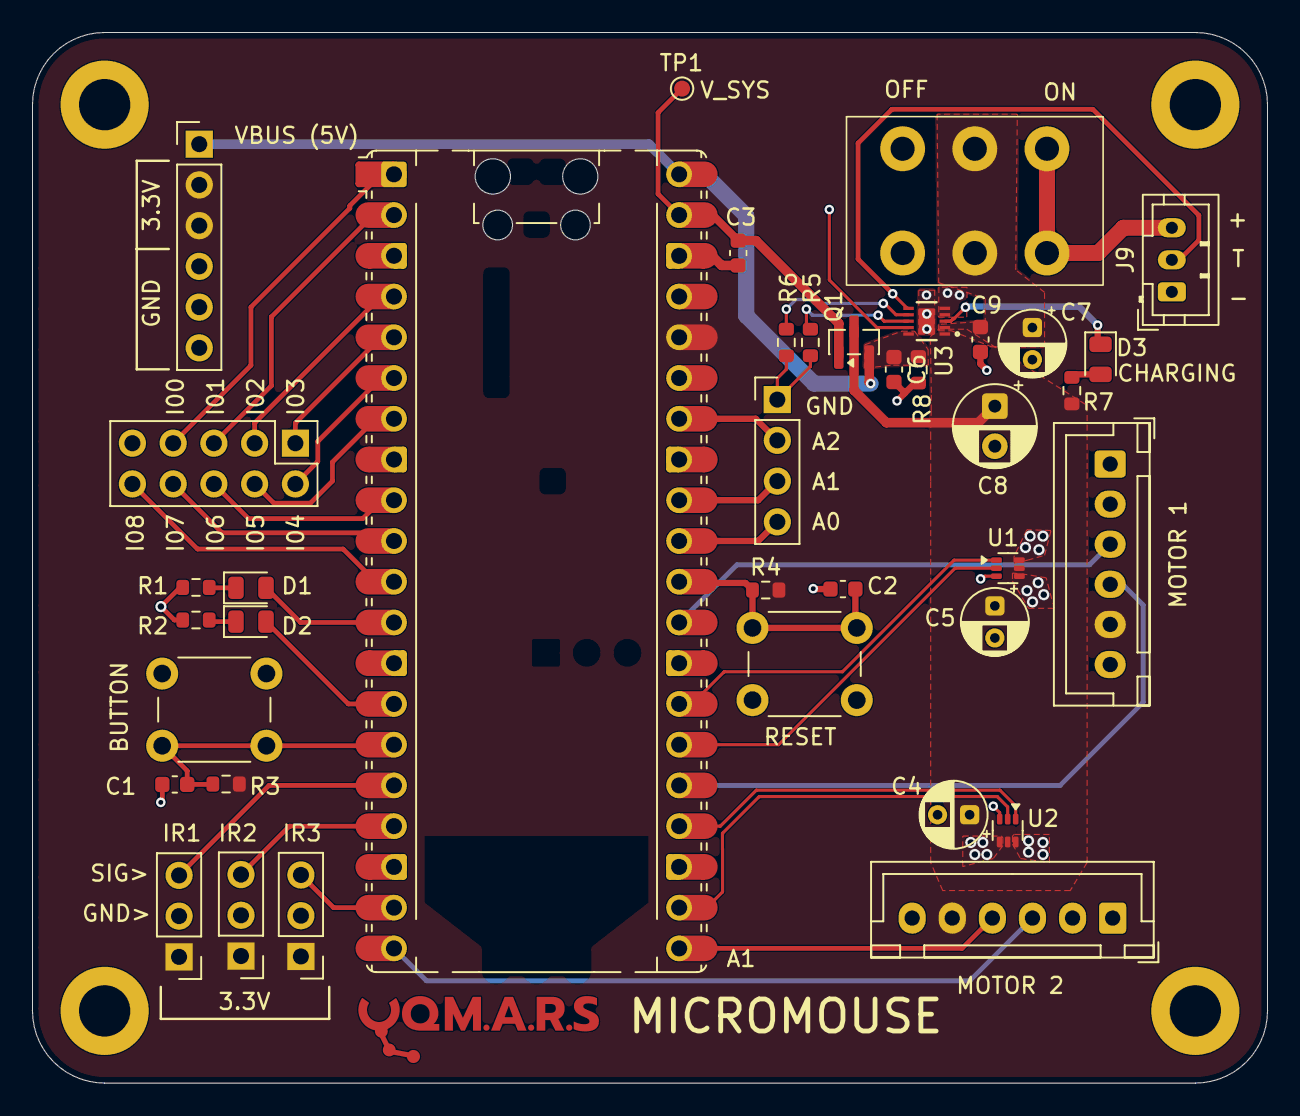
[picture p21: board MARS_Micromouse.kicad_pcb from above]

Board: 2 copper layers, 77.0 x 65.5 mm, 43 parts (1 on the bottom side), 46 nets.
