uqmars/starter-micromouse/(commit log)

2025-12-20 Implemented a basic structure for the device drivers with basic LED control.
2025-12-29 Added further LED, IR, and motor pinouts, and added basic motor driving code.
2026-01-03 Added IR Object Sensor functionality, and added some response to the base main implementation.
2026-01-04 Framework made
2026-01-04 Updates complete
    - Added pwm control to the motors
    - Added various helper functions to read various sensors
    - Renamed IR and motor scheme to make it consistent with the PCB markings
2026-01-06 PCB Files, CAD, and draft BOM document added
    [Bill of Materials.xlsx, MARS Micromouse.f3z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]
2026-07-11 Added micromouse assembly instructions
    [Base Plate.ipt, CP_Radial_D4.0mm_P2.00mm.ipt, CP_Radial_D5.0mm_P2.50mm.ipt, C_0603_1608Metric.ipt, Caster Ball Extension.ipt, Caster Ball v3.ipt, D_SOD-123F.ipt, Housing.ipt]
2026-08-11 Added V2 Micromouse PCB Design
    [Base Plate.stl, Bill of Materials.xlsx, Caster Ball Extension.stl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]
